itdaniher/auv-controller/board.png

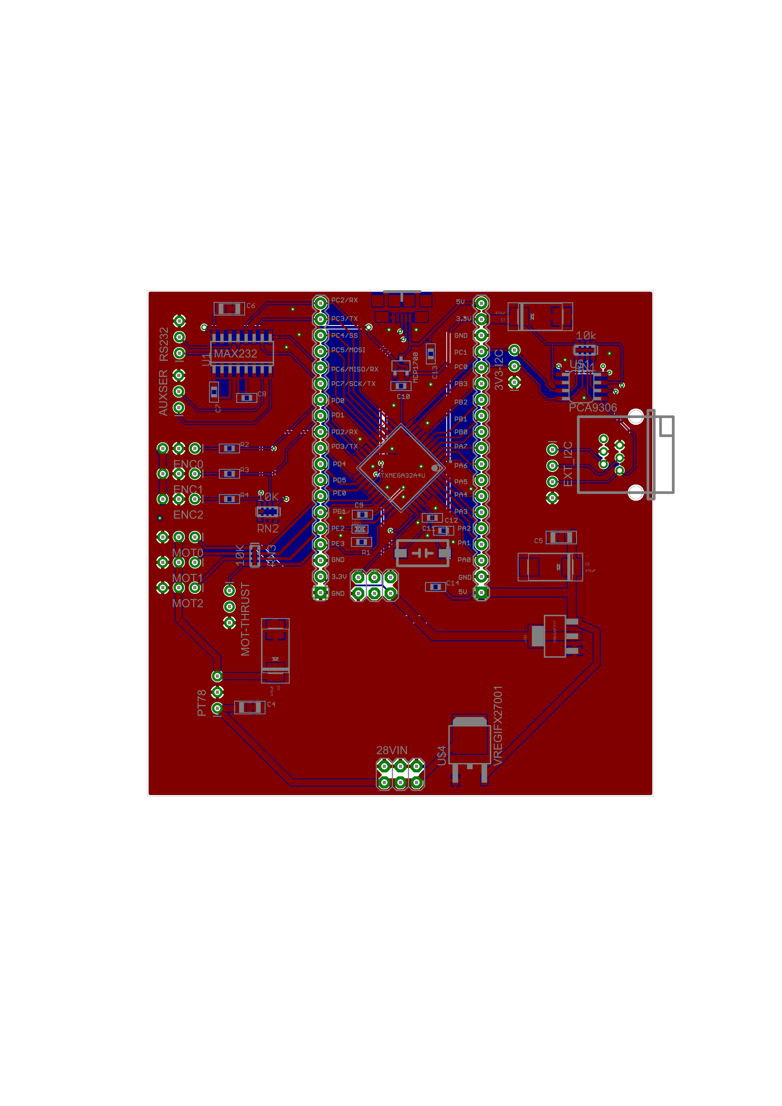
board.png
