itdaniher/auv-controller/schematic.png

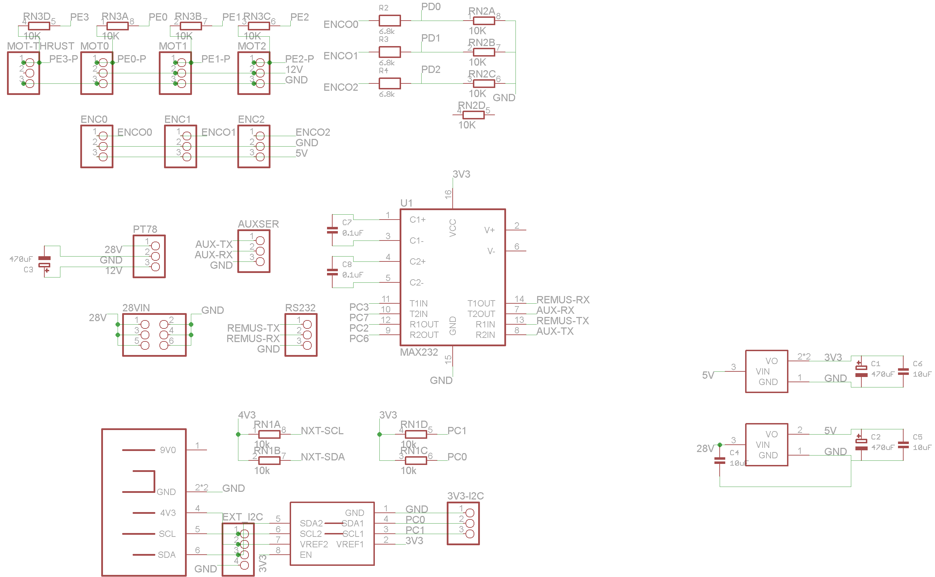
schematic.png
