itdaniher/auv-controller/mechanical/000_v3_REMUS_Tail_Assem.pdf

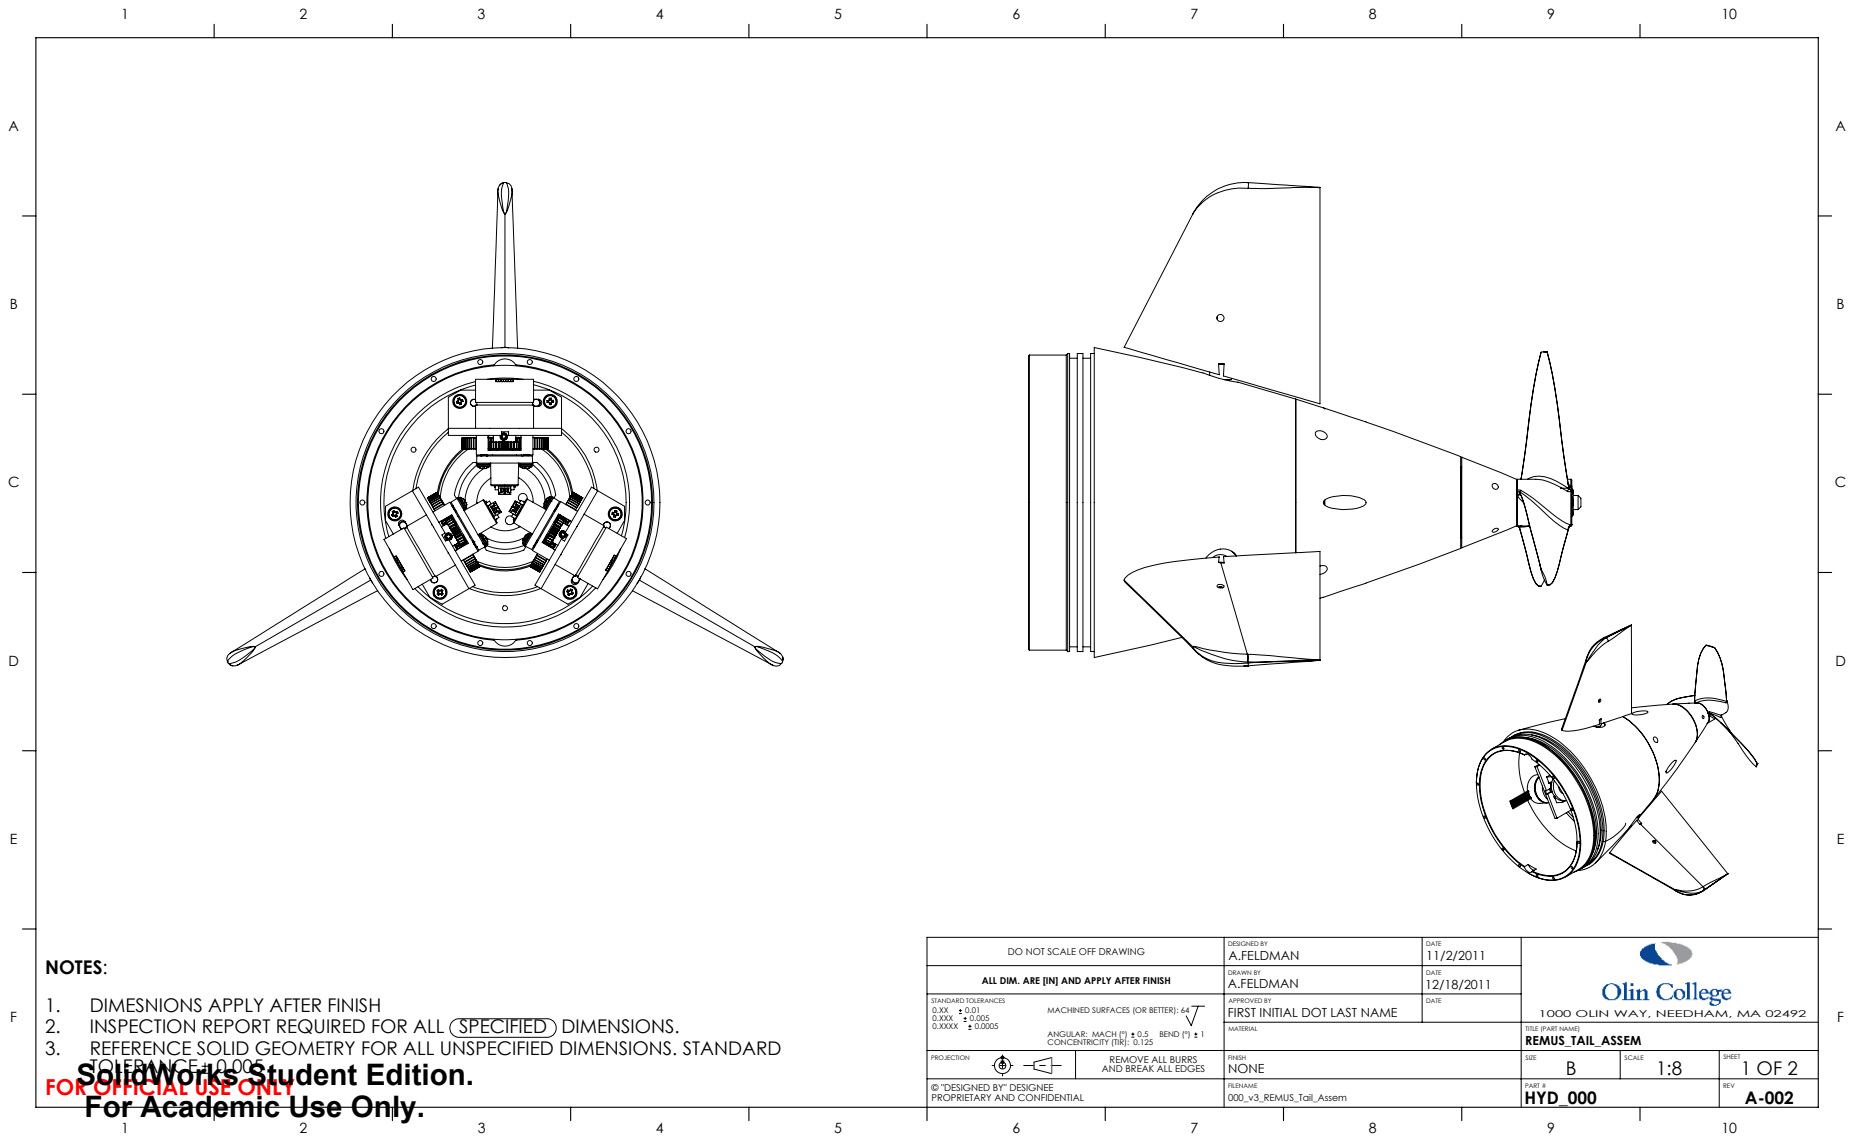
[picture p33: page 1]
2. INSPECTION REPORT REQUIRED FOR ALL; SPECIFIED; DIMENSIONS.; TOLERANCE; 0.005 SolidWorks Student Edition.

DO NOT SCALE OFF DRAWING | DESIGNED BY A.FELDMAN | DATE 11/2/2011 | 1000 OLIN WAY, NEEDHAM, MA 02492

NOTES:
1. DIMESNIONS APPLY AFTER FINISH
3. REFERENCE SOLID GEOMETRY FOR ALL UNSPECIFIED DIMENSIONS. STANDARD
HYD_000 FOR OFFICIAL USE ONLY
For Academic Use Only.

ALL DIM. ARE [IN] AND APPLY AFTER FINISH | DRAWN BY A.FELDMAN | DATE 12/18/2011

STANDARD TOLERANCES 0.XX 0.01 MACHINED SURFACES (OR BETTER): 64 0.XXX 0.005 0.XXXX 0.0005 ANGULAR: MACH (º) 0.5 BEND (º) 1 CONCENTRICITY (TIR): 0.125 | APPROVED BY FIRST INITIAL DOT LAST NAME | DATE

MATERIAL | | TITLE (PART NAME) REMUS_TAIL_ASSEM

PROJECTION | | | | REMOVE ALL BURRS AND BREAK ALL EDGES | FINISH NONE | SIZE B | SCALE 1:8 | SHEET 1 OF 2

© "DESIGNED BY" DESIGNEE PROPRIETARY AND CONFIDENTIAL | | | | | FILENAME 000_v3_REMUS_Tail_Assem | PART # | | REV A-002

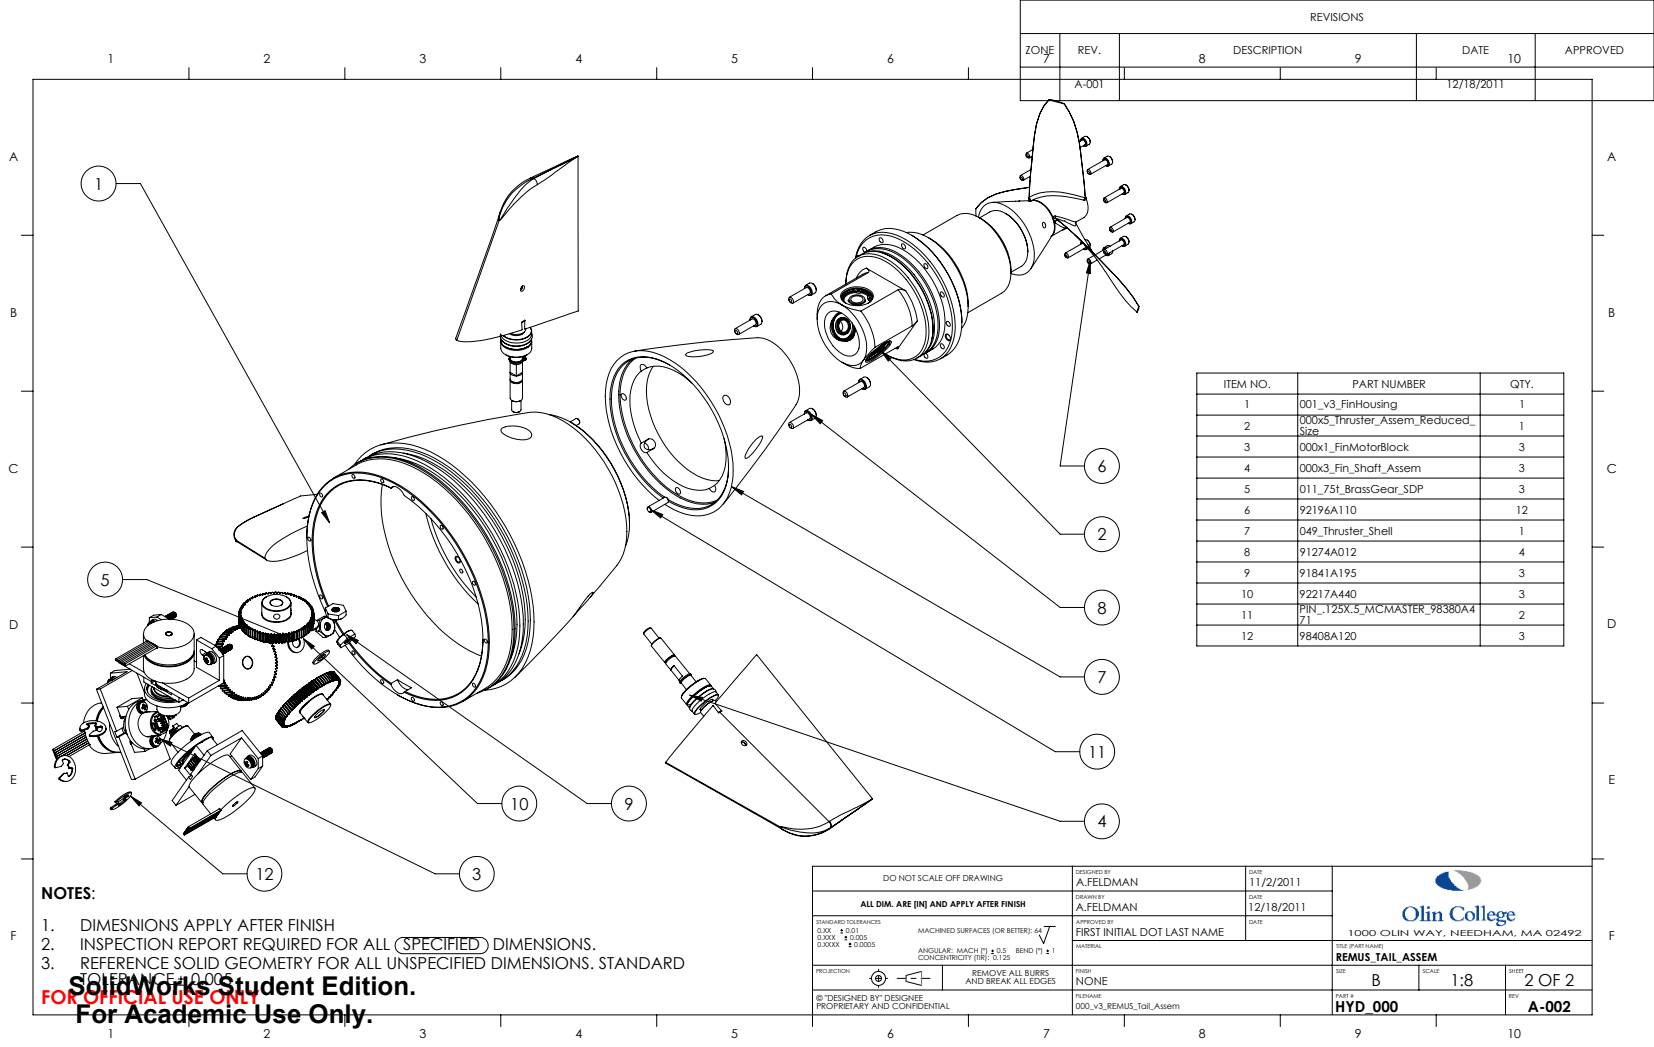
[picture p34: page 2]
2. INSPECTION REPORT REQUIRED FOR ALL; SPECIFIED; DIMENSIONS.; TOLERANCE; 0.005 SolidWorks Student Edition.

ITEM NO. | PART NUMBER | QTY.
1 | 001_v3_FinHousing | 1
2 | 000x5_Thruster_Assem_Reduced_ Size | 1
3 | 000x1_FinMotorBlock | 3
4 | 000x3_Fin_Shaft_Assem | 3
5 | 011_75t_BrassGear_SDP | 3
6 | 92196A110 | 12
7 | 049_Thruster_Shell | 1
8 | 91274A012 | 4
9 | 91841A195 | 3
10 | 92217A440 | 3
11 | PIN_.125X.5_MCMASTER_98380A4 71 | 2
12 | 98408A120 | 3

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

ALL DIM. ARE [IN] AND APPLY AFTER FINISH | DRAWN BY A.FELDMAN | DATE 12/18/2011

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

MATERIAL | | TITLE (PART NAME) REMUS_TAIL_ASSEM

PROJECTION | | | | REMOVE ALL BURRS AND BREAK ALL EDGES | FINISH NONE | SIZE B | SCALE 1:8 | SHEET 2 OF 2

© "DESIGNED BY" DESIGNEE PROPRIETARY AND CONFIDENTIAL | | | | | FILENAME 000_v3_REMUS_Tail_Assem | PART # | | REV A-002
