itdaniher/auv-controller/mechanical/000x1_FinMotorBlock.pdf

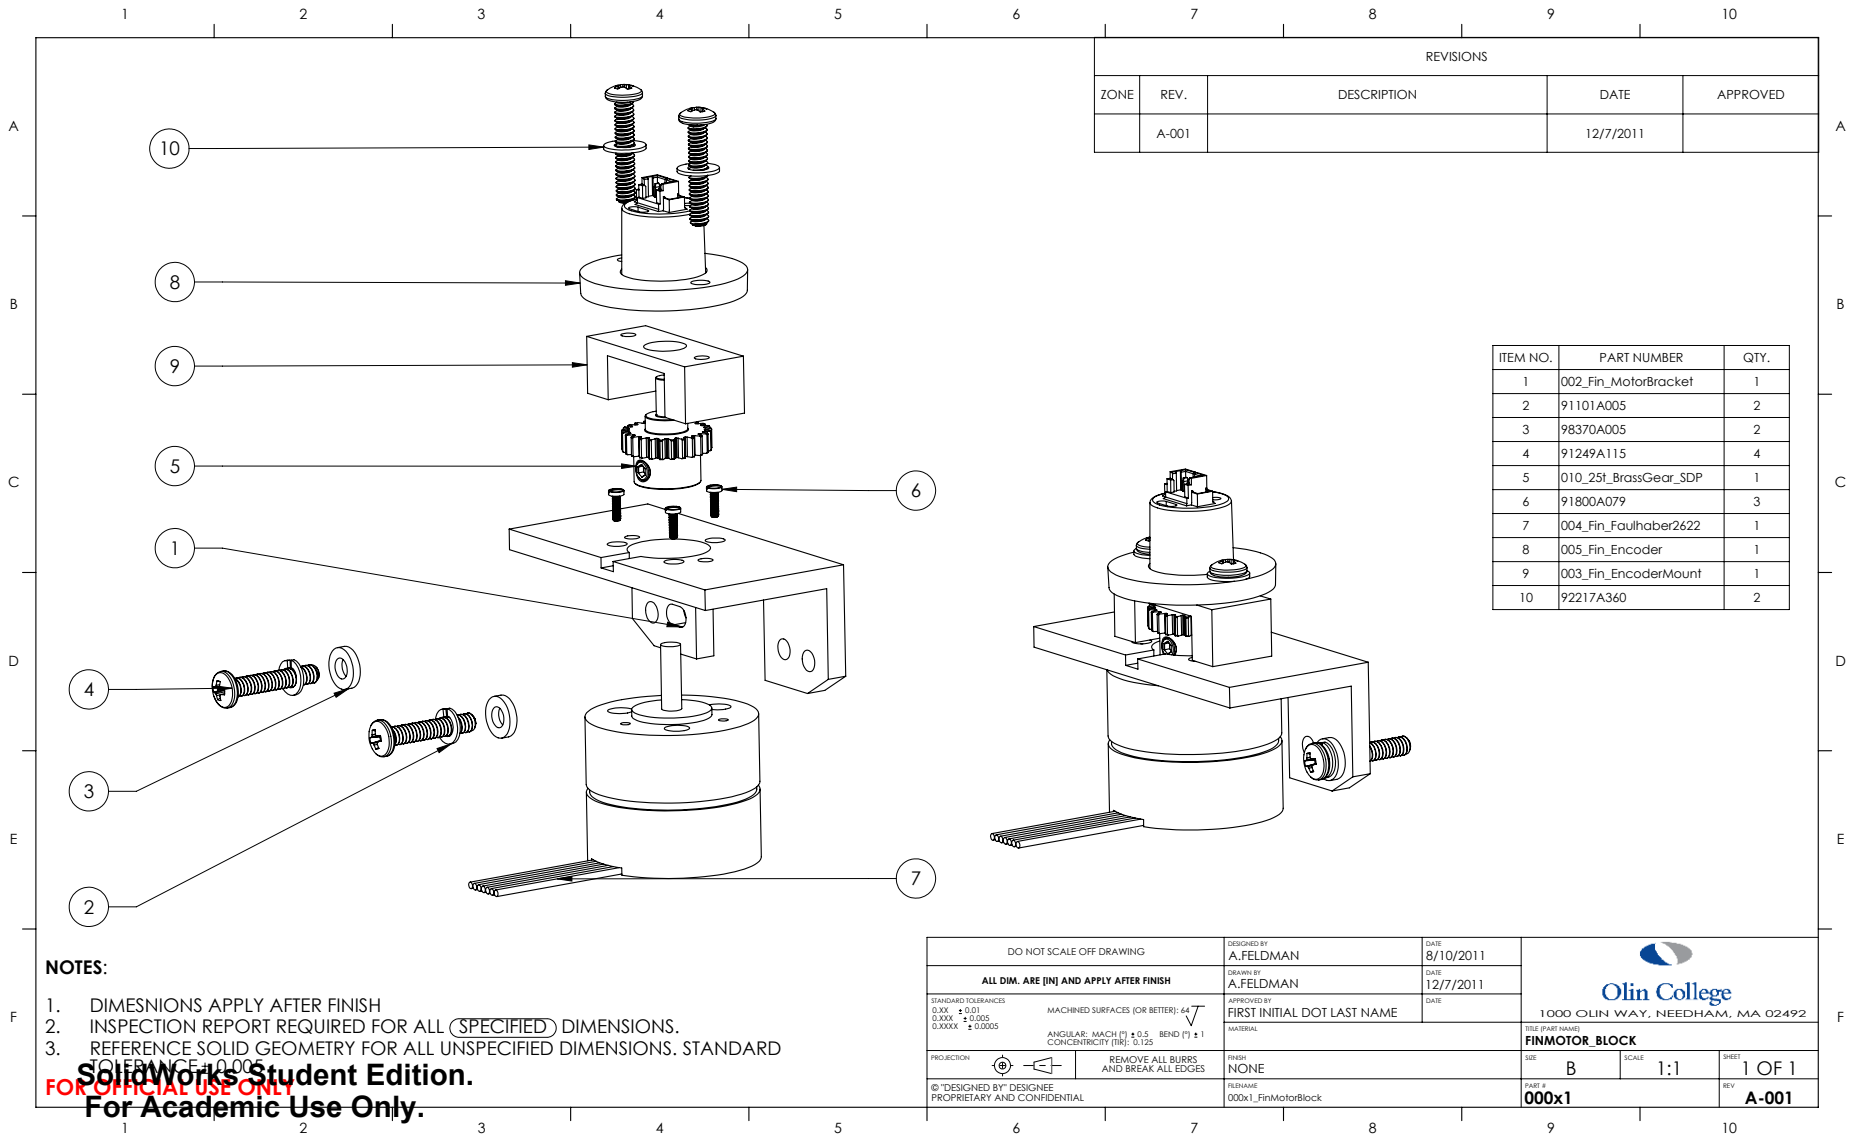
[picture p35: page 1]
2. INSPECTION REPORT REQUIRED FOR ALL; SPECIFIED; DIMENSIONS.; TOLERANCE; 0.005 SolidWorks Student Edition.

REVISIONS

ZONE | REV. | DESCRIPTION | DATE | APPROVED

ITEM NO. | PART NUMBER | QTY.
1 | 002_Fin_MotorBracket | 1
2 | 91101A005 | 2
3 | 98370A005 | 2
4 | 91249A115 | 4
5 | 010_25t_BrassGear_SDP | 1
6 | 91800A079 | 3
7 | 004_Fin_Faulhaber2622 | 1
8 | 005_Fin_Encoder | 1
9 | 003_Fin_EncoderMount | 1
10 | 92217A360 | 2

DO NOT SCALE OFF DRAWING | DESIGNED BY A.FELDMAN | DATE 8/10/2011 | 1000 OLIN WAY, NEEDHAM, MA 02492

NOTES:
1. DIMESNIONS APPLY AFTER FINISH
3. REFERENCE SOLID GEOMETRY FOR ALL UNSPECIFIED DIMENSIONS. STANDARD
000x1 FOR OFFICIAL USE ONLY
For Academic Use Only.

ALL DIM. ARE [IN] AND APPLY AFTER FINISH | DRAWN BY A.FELDMAN | DATE 12/7/2011

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

MATERIAL | | TITLE (PART NAME) FINMOTOR_BLOCK

PROJECTION | | | | REMOVE ALL BURRS AND BREAK ALL EDGES | FINISH NONE | SIZE B | SCALE 1:1 | SHEET 1 OF 1

© "DESIGNED BY" DESIGNEE PROPRIETARY AND CONFIDENTIAL | | | | | FILENAME 000x1_FinMotorBlock | PART # | | REV A-001
