itdaniher/auv-controller/mechanical/000x6_Thruster_Assem_Stator.pdf

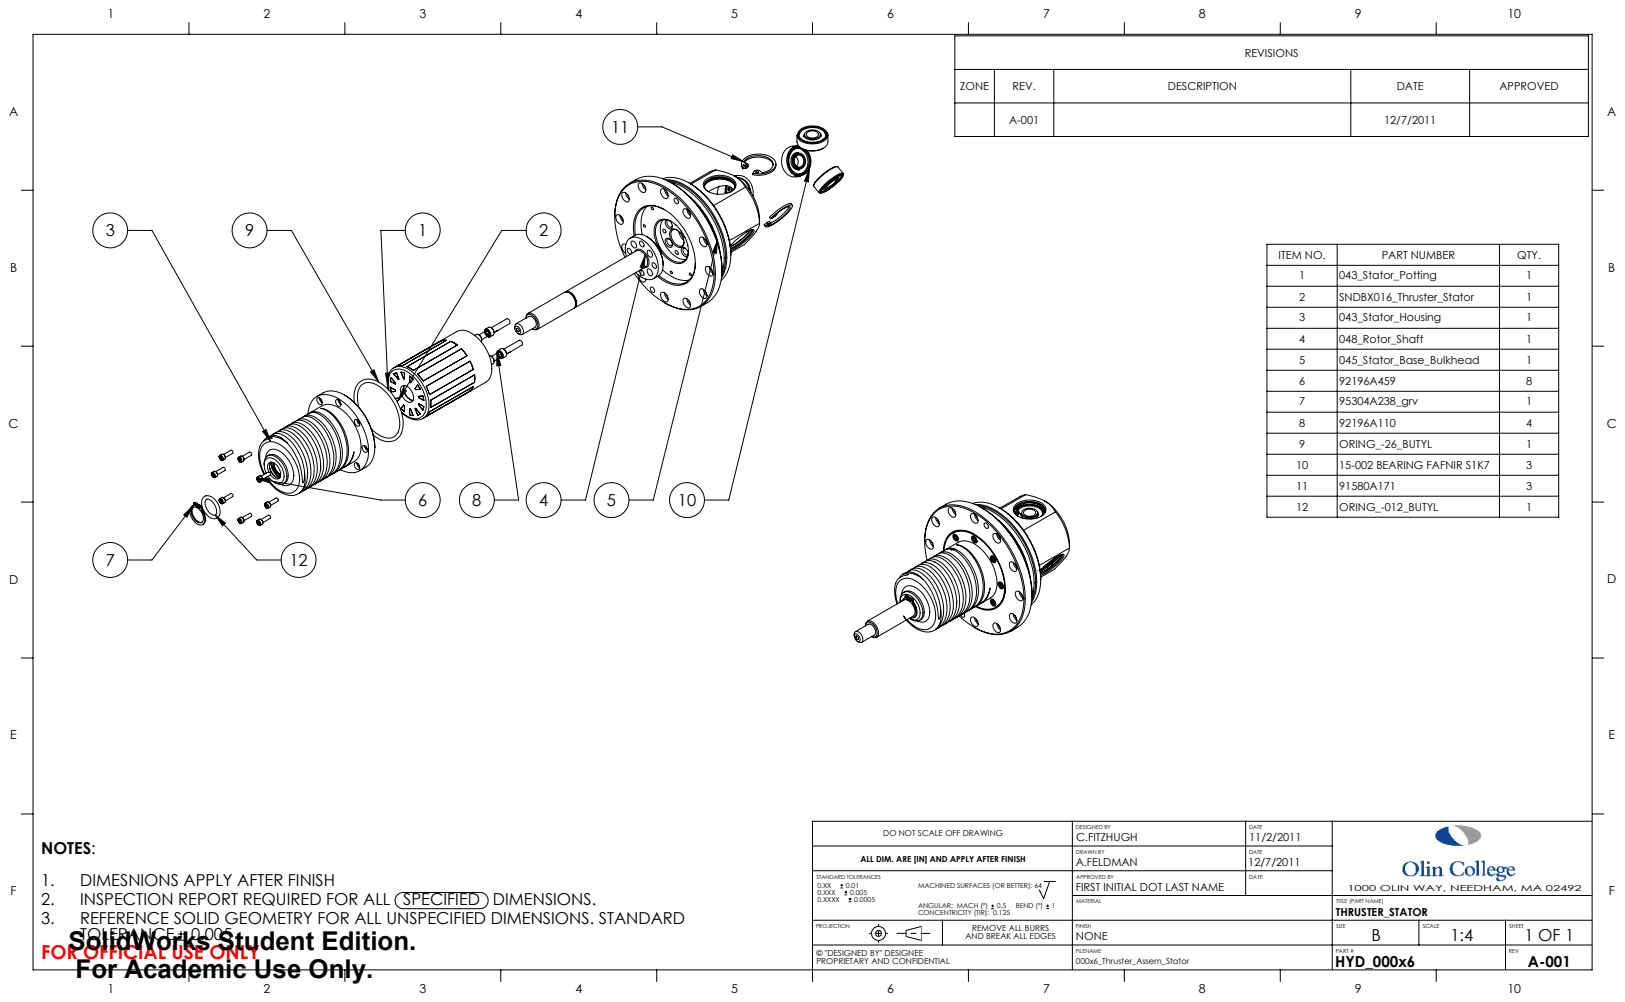
[picture p36: page 1]
2. INSPECTION REPORT REQUIRED FOR ALL; SPECIFIED; DIMENSIONS.; TOLERANCE; 0.005 SolidWorks Student Edition.

ZONE | REV. | DESCRIPTION | DATE | APPROVED

ITEM NO. | PART NUMBER | QTY.
1 | 043_Stator_Potting | 1
2 | SNDBX016_Thruster_Stator | 1
3 | 043_Stator_Housing | 1
4 | 048_Rotor_Shaft | 1
5 | 045_Stator_Base_Bulkhead | 1
6 | 92196A459 | 8
7 | 95304A238_grv | 1
8 | 92196A110 | 4
9 | ORING_-26_BUTYL | 1
10 | 15-002 BEARING FAFNIR S1K7 | 3
11 | 91580A171 | 3
12 | ORING_-012_BUTYL | 1

DO NOT SCALE OFF DRAWING | DESIGNED BY C.FITZHUGH | DATE 11/2/2011 | 1000 OLIN WAY, NEEDHAM, MA 02492

NOTES:
1. DIMESNIONS APPLY AFTER FINISH
3. REFERENCE SOLID GEOMETRY FOR ALL UNSPECIFIED DIMENSIONS. STANDARD
HYD_000x6 FOR OFFICIAL USE ONLY
For Academic Use Only.

ALL DIM. ARE [IN] AND APPLY AFTER FINISH | DRAWN BY A.FELDMAN | DATE 12/7/2011

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

MATERIAL | | TITLE (PART NAME) THRUSTER_STATOR

PROJECTION | | | | REMOVE ALL BURRS AND BREAK ALL EDGES | FINISH NONE | SIZE B | SCALE 1:4 | SHEET 1 OF 1

© "DESIGNED BY" DESIGNEE PROPRIETARY AND CONFIDENTIAL | | | | | FILENAME 000x6_Thruster_Assem_Stator | PART # | | REV A-001
