itdaniher/auv-controller/mechanical/001_v3_FinHousing.pdf

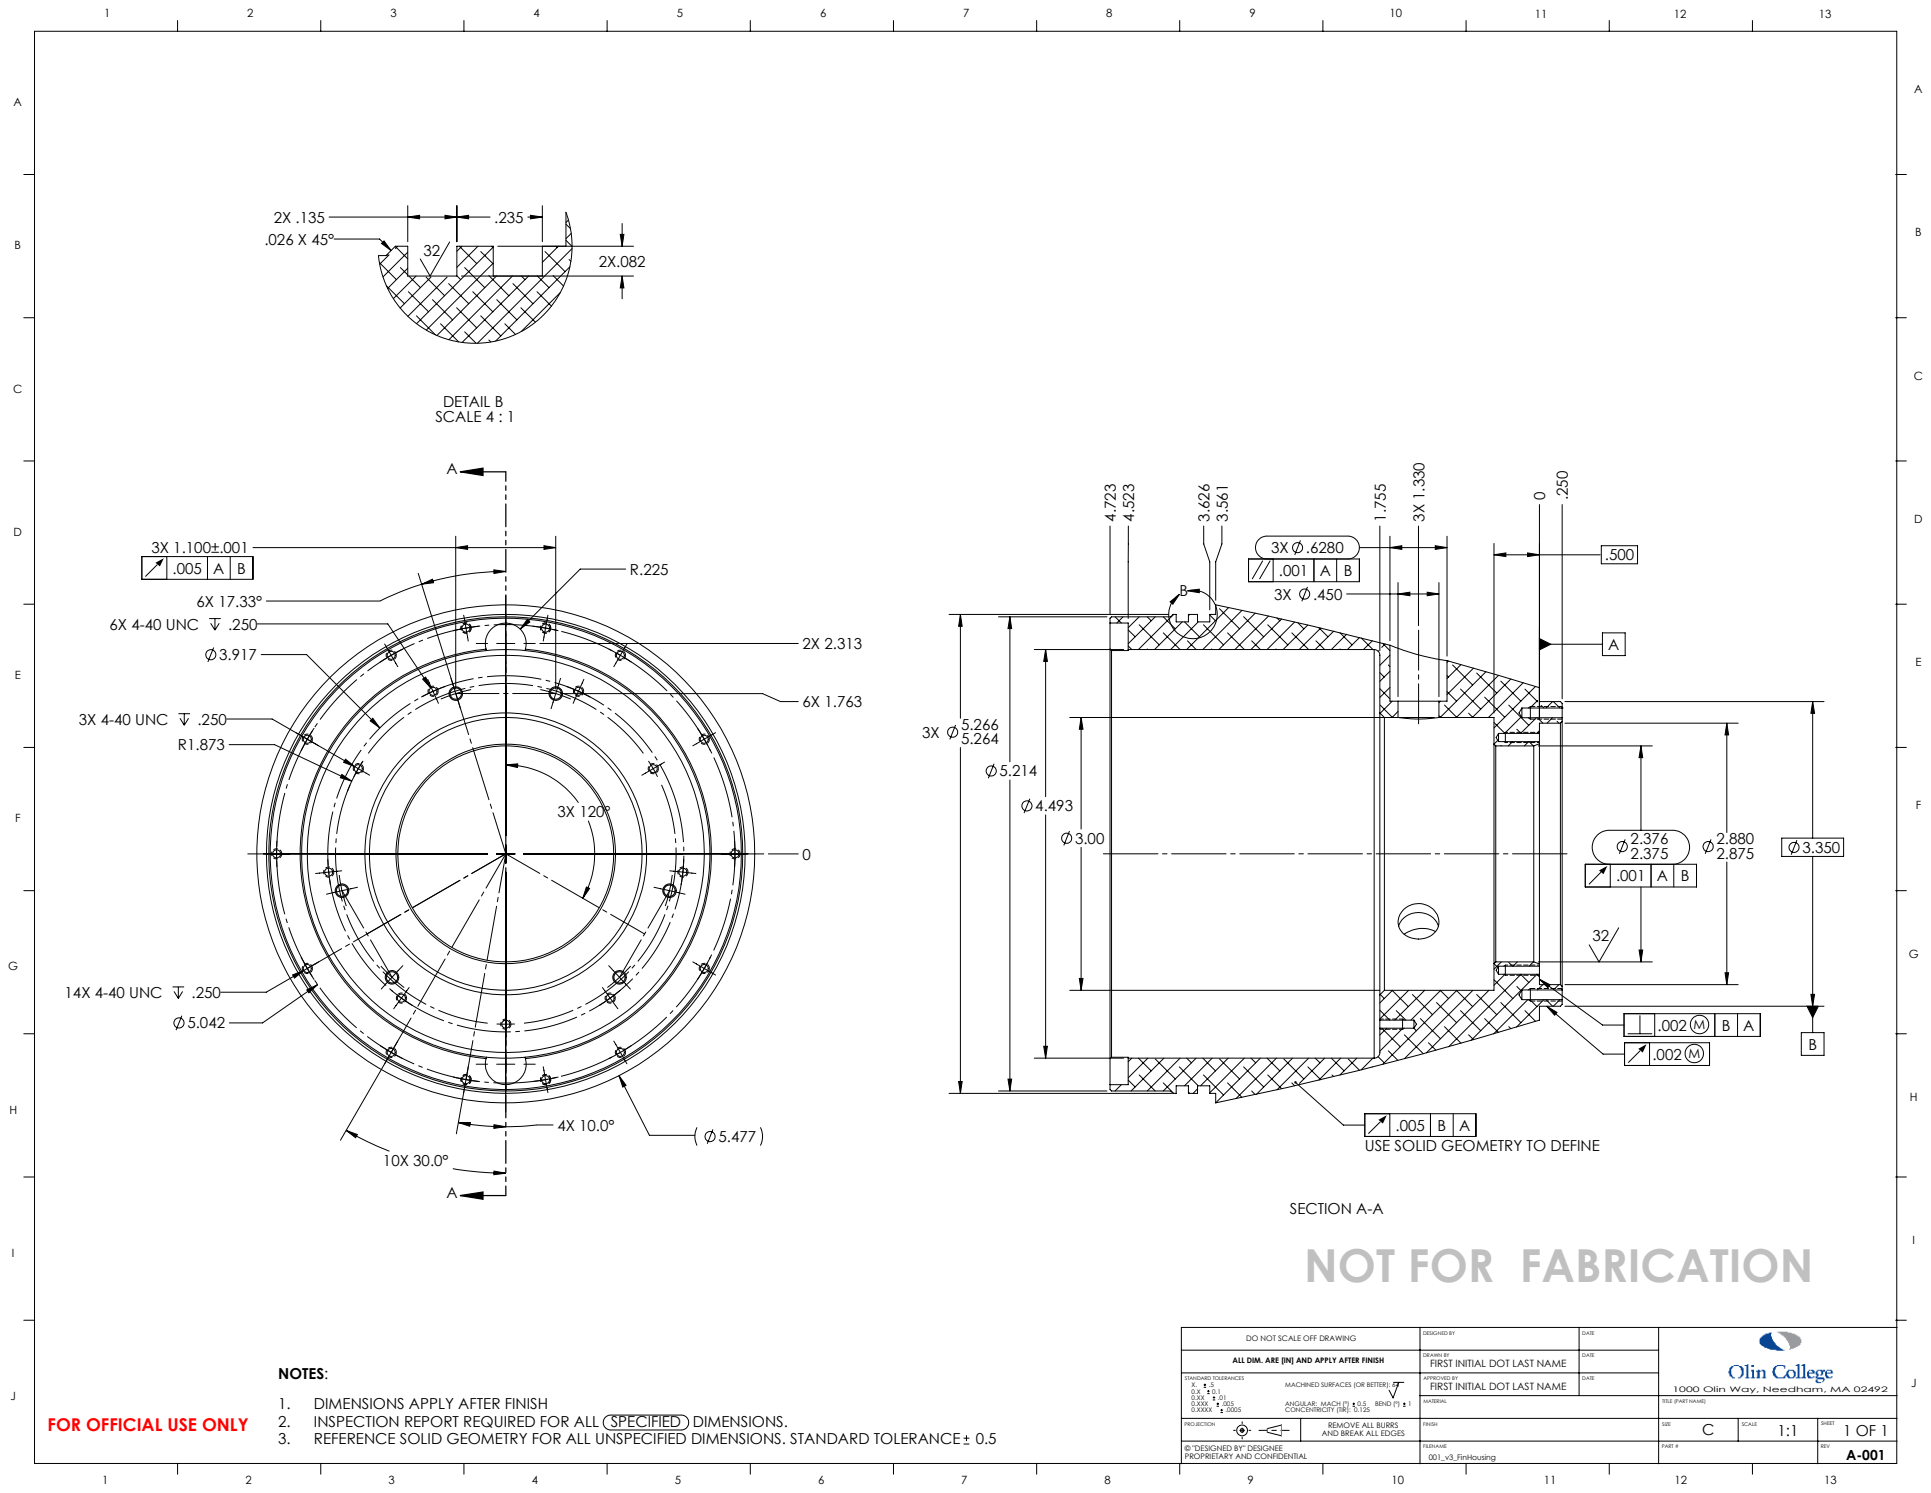
[picture p37: page 1]
3X 4-40 UNC; 6X 4-40 UNC; 14X 4-40 UNC; SECTION A-A; DETAIL B SCALE 4 : 1; 3. REFERENCE SOLID GEOMETRY FOR ALL UNSPECIFIED DIMENSIONS. STANDARD TOLERANCE; 1:1 FOR OFFICIAL USE ONLY

USE SOLID GEOMETRY TO DEFINE
NOT FOR FABRICATION

DO NOT SCALE OFF DRAWING | DESIGNED BY | DATE | 1000 Olin Way, Needham, MA 02492

ALL DIM. ARE [IN] AND APPLY AFTER FINISH | DRAWN BY FIRST INITIAL DOT LAST NAME | DATE

NOTES:
1. DIMENSIONS APPLY AFTER FINISH
2. INSPECTION REPORT REQUIRED FOR ALL SPECIFIED DIMENSIONS.

STANDARD TOLERANCES X. .5 0.X 0.1 MACHINED SURFACES (OR BETTER): 64 0.XX .01 0.XXX .005 ANGULAR: MACH (º) 0.5 BEND (º) 1 0.XXXX .0005 CONCENTRICITY (TIR): 0.125 | APPROVED BY FIRST INITIAL DOT LAST NAME | DATE

MATERIAL | | TITLE (PART NAME)

PROJECTION | | | | REMOVE ALL BURRS AND BREAK ALL EDGES | FINISH | SIZE | SCALE | SHEET

© "DESIGNED BY" DESIGNEE PROPRIETARY AND CONFIDENTIAL | | | | | FILENAME 001_v3_FinHousing | PART # | | REV A-001
