itdaniher/auv-controller/board.brd

## EAGLE design board.brd (2012-12-20)

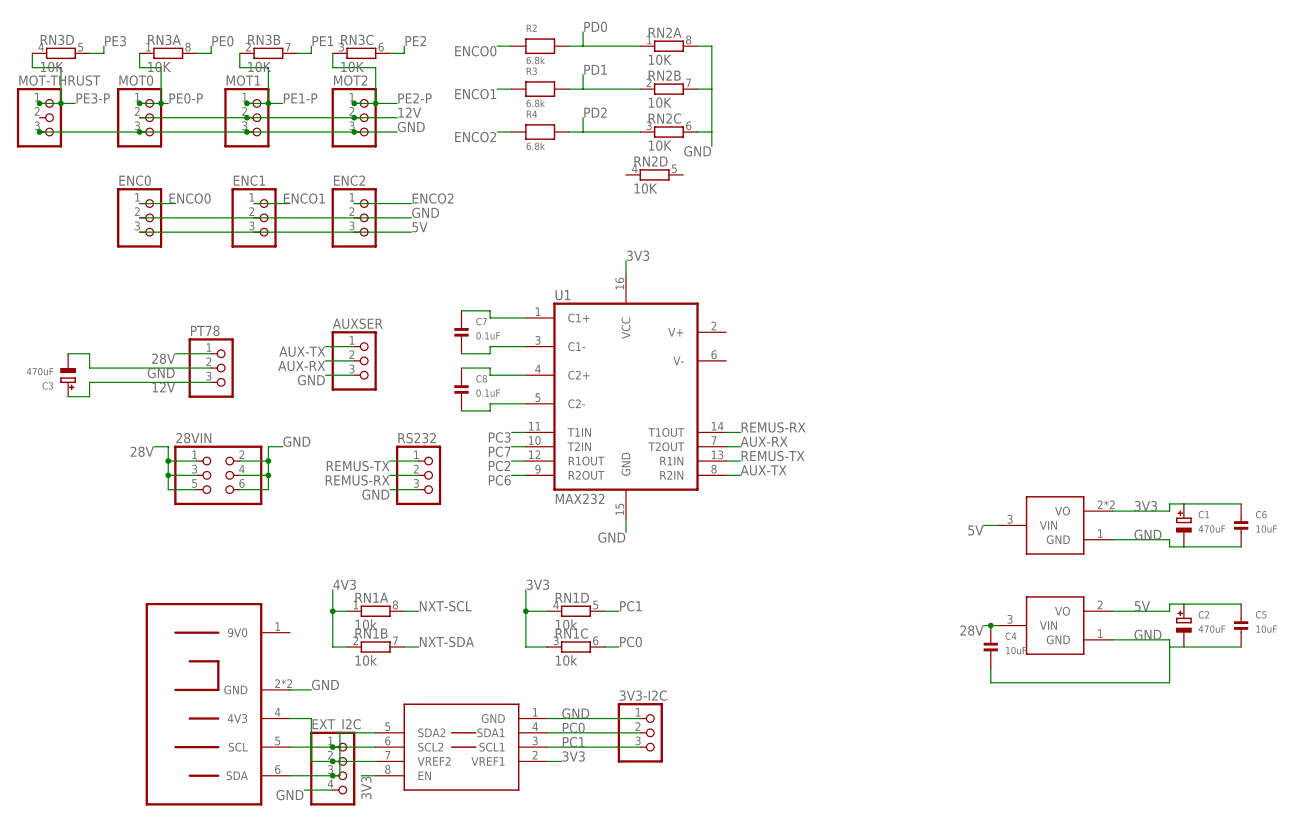
[picture p38: schematic board.sch, sheet 1]

Parts:
3V3-I2C: HEADER-1X3ROUND; 1X03_ROUND
28VIN: HEADER-2X3; 2X03
AUXSER: HEADER-1X3ROUND; 1X03_ROUND
C1, C2, C3: 470uF; EIA7343-31/D-W
C4, C5, C6: 10uF; 1206
C7, C8: 0.1uF; 0603
ENC0, ENC1, ENC2: HEADER-1X3ROUND; 1X03_ROUND
EXT_I2C: HEADER-1X4ROUND; 1X04_ROUND
MOT0, MOT1, MOT2: HEADER-1X3ROUND; 1X03_ROUND
MOT-THRUST: HEADER-1X3ROUND; 1X03_ROUND
PT78: HEADER-1X3ROUND; 1X03_ROUND
R2, R3, R4: 6.8k; 0603
RN1: 10k; RN8P-4R-CRA06S
RN2, RN3: 10K; RN8P-4R-CRA06S
RS232: HEADER-1X3ROUND; 1X03_ROUND
U1: MAX232; SO-16
U$1: PCA9306; SO-08
U$2: NXT-CONNECTOR; NXT-FOOTPRINT
U$3: VREGAP1117; SOT223
U$4: VREGIFX27001; TO252

Connections:
3V3: C1.+, C6.1, RN1.3 (1), RN1.4 (1), U1.16 (VCC), U$1.2 (VREF1), U$1.8 (EN), U$3.2 (VO), U$3.4 (VO); also elsewhere on the board
4V3: EXT_I2C.2, RN1.1, RN1.2 (1), U$1.7 (VREF2), U$2.4 (4V3)
5V: C2.+, C5.1, ENC0.3, ENC1.3, ENC2.3, U$3.3 (VIN), U$4.2 (VO); also elsewhere on the board
12V: C3.+, MOT0.2, MOT1.2, MOT2.2, PT78.3
28V: 28VIN.1, 28VIN.3, 28VIN.5, C4.1, PT78.1, U$4.3 (VIN)
AUX-RX: AUXSER.2, U1.7 (T2OUT)
AUX-TX: AUXSER.1, U1.8 (R2IN)
C1+: C7.1, U1.1 (C1+)
C1-: C7.2, U1.3 (C1-)
C2+: C8.1, U1.4 (C2+)
C2-: C8.2, U1.5 (C2-)
ENCO0: ENC0.1, R2.1
ENCO1: ENC1.1, R3.1
ENCO2: ENC2.1, R4.1
GND: 3V3-I2C.1, 28VIN.2, 28VIN.4, 28VIN.6, AUXSER.3, C1.-, C3.-, C4.2, C5.2, C6.2, ENC0.2, ENC1.2, ENC2.2, EXT_I2C.4, MOT0.3, MOT1.3, MOT2.3, MOT-THRUST.3, PT78.2, RN2.6 (2), RN2.7 (2), RN2.8 (2), RS232.3, U1.15 (GND), U$1.1 (GND), U$2.2 (GND), U$2.3 (GND), U$3.1 (GND), U$4.1 (GND); also elsewhere on the board
NXT-SCL: EXT_I2C.1, RN1.8 (2), U$1.6 (SCL2), U$2.5 (SCL)
NXT-SDA: EXT_I2C.3, RN1.7 (2), U$1.5 (SDA2), U$2.6 (SDA)
PC0: 3V3-I2C.2, RN1.6 (2), U$1.4 (SDA1); also elsewhere on the board
PC1: 3V3-I2C.3, RN1.5 (2), U$1.3 (SCL1); also elsewhere on the board
PC2: U1.12 (R1OUT); also elsewhere on the board
PC3: U1.11 (T1IN); also elsewhere on the board
PC6: U1.9 (R2OUT); also elsewhere on the board
PC7: U1.10 (T2IN); also elsewhere on the board
PD0: R2.2, RN2.1; also elsewhere on the board
PD1: R3.2, RN2.2 (1); also elsewhere on the board
PD2: R4.2, RN2.3 (1); also elsewhere on the board
PE0: RN3.8 (2); also elsewhere on the board
PE0-P: MOT0.1, RN3.1
PE1: RN3.7 (2); also elsewhere on the board
PE1-P: MOT1.1, RN3.2 (1)
PE2: RN3.6 (2); also elsewhere on the board
PE2-P: MOT2.1, RN3.3 (1)
PE3: RN3.5 (2); also elsewhere on the board
PE3-P: MOT-THRUST.1, RN3.4 (1)
REMUS-RX: RS232.2, U1.14 (T1OUT)
REMUS-TX: RS232.1, U1.13 (R1IN)

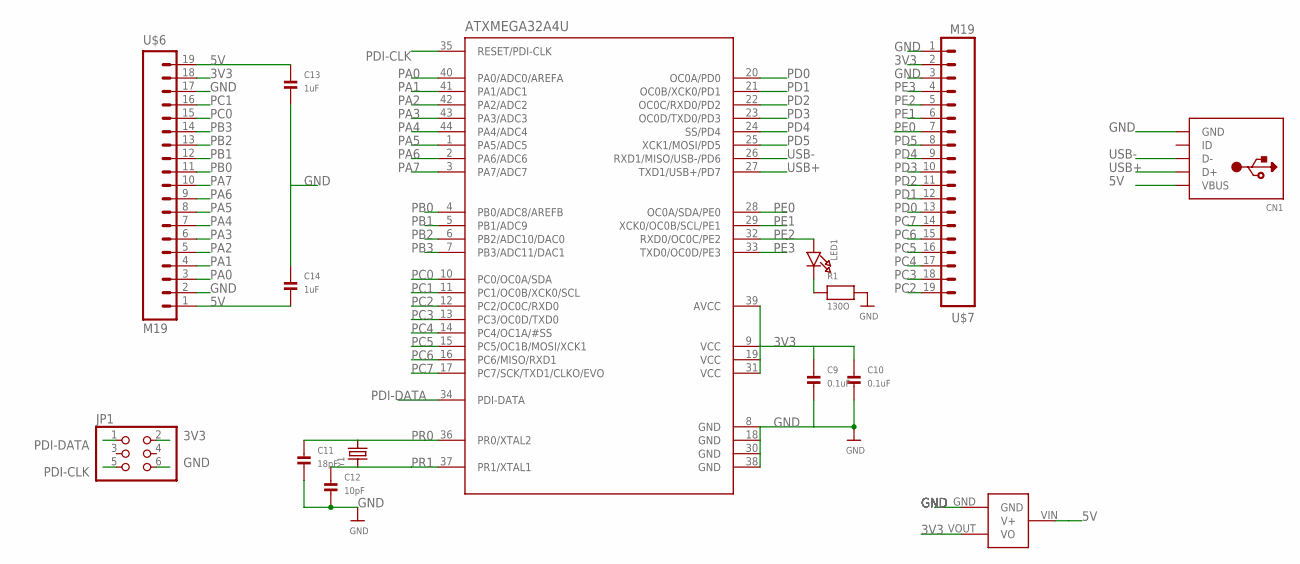
[picture p39: schematic board.sch, sheet 2]

Parts:
ATXMEGA32A4U: ATXMEGAXXA4U-AU; TQFP-44
C9, C10: 0.1uF; 0603
C11: 18pF; 0603
C12: 10pF; 0603
C13, C14: 1uF; 0603
CN1: USBMICROB; USB-MICROB
JP1: HEADER-2X3; 2X03
LED1: LED0603; CHIPLED_0603
R1: 130O; 0603
U$5: MCP1700; SOT23-3
U$6, U$7: M19; 1X19
Y1: CRYSTAL; NX8045GB

Connections:
3V3: ATXMEGA32A4U.9 (VCC), ATXMEGA32A4U.19 (VCC), ATXMEGA32A4U.31 (VCC), ATXMEGA32A4U.39 (AVCC), C9.1, C10.1, JP1.2, U$5.VOUT (VO), U$6.18, U$7.2; also elsewhere on the board
5V: C13.1, C14.2, CN1.P1 (VBUS), U$5.VIN (V+), U$6.1, U$6.19; also elsewhere on the board
GND: ATXMEGA32A4U.8 (GND), ATXMEGA32A4U.18 (GND), ATXMEGA32A4U.30 (GND), ATXMEGA32A4U.38 (GND), C9.2, C10.2, C11.2, C12.2, C13.2, C14.1, CN1.P5 (GND), JP1.6, R1.2, U$5.GND, U$6.2, U$6.17, U$7.1, U$7.3; also elsewhere on the board
unnamed: LED1.C, R1.1
PA0: ATXMEGA32A4U.40 (PA0/ADC0/AREFA), U$6.3
PA1: ATXMEGA32A4U.41 (PA1/ADC1), U$6.4
PA2: ATXMEGA32A4U.42 (PA2/ADC2), U$6.5
PA3: ATXMEGA32A4U.43 (PA3/ADC3), U$6.6
PA4: ATXMEGA32A4U.44 (PA4/ADC4), U$6.7
PA5: ATXMEGA32A4U.1 (PA5/ADC5), U$6.8
PA6: ATXMEGA32A4U.2 (PA6/ADC6), U$6.9
PA7: ATXMEGA32A4U.3 (PA7/ADC7), U$6.10
PB0: ATXMEGA32A4U.4 (PB0/ADC8/AREFB), U$6.11
PB1: ATXMEGA32A4U.5 (PB1/ADC9), U$6.12
PB2: ATXMEGA32A4U.6 (PB2/ADC10/DAC0), U$6.13
PB3: ATXMEGA32A4U.7 (PB3/ADC11/DAC1), U$6.14
PC0: ATXMEGA32A4U.10 (PC0/OC0A/SDA), U$6.15; also elsewhere on the board
PC1: ATXMEGA32A4U.11 (PC1/OC0B/XCK0/SCL), U$6.16; also elsewhere on the board
PC2: ATXMEGA32A4U.12 (PC2/OC0C/RXD0), U$7.19; also elsewhere on the board
PC3: ATXMEGA32A4U.13 (PC3/OC0D/TXD0), U$7.18; also elsewhere on the board
PC4: ATXMEGA32A4U.14 (PC4/OC1A/#SS), U$7.17
PC5: ATXMEGA32A4U.15 (PC5/OC1B/MOSI/XCK1), U$7.16
PC6: ATXMEGA32A4U.16 (PC6/MISO/RXD1), U$7.15; also elsewhere on the board
PC7: ATXMEGA32A4U.17 (PC7/SCK/TXD1/CLKO/EVO), U$7.14; also elsewhere on the board
PD0: ATXMEGA32A4U.20 (OC0A/PD0), U$7.13; also elsewhere on the board
PD1: ATXMEGA32A4U.21 (OC0B/XCK0/PD1), U$7.12; also elsewhere on the board
PD2: ATXMEGA32A4U.22 (OC0C/RXD0/PD2), U$7.11; also elsewhere on the board
PD3: ATXMEGA32A4U.23 (OC0D/TXD0/PD3), U$7.10
PD4: ATXMEGA32A4U.24 (SS/PD4), U$7.9
PD5: ATXMEGA32A4U.25 (XCK1/MOSI/PD5), U$7.8
PDI-CLK: ATXMEGA32A4U.35 (RESET/PDI-CLK), JP1.5
PDI-DATA: ATXMEGA32A4U.34 (PDI-DATA), JP1.1
PE0: ATXMEGA32A4U.28 (OC0A/SDA/PE0), U$7.7; also elsewhere on the board
PE1: ATXMEGA32A4U.29 (XCK0/OC0B/SCL/PE1), U$7.6; also elsewhere on the board
PE2: ATXMEGA32A4U.32 (RXD0/OC0C/PE2), LED1.A, U$7.5; also elsewhere on the board
PE3: ATXMEGA32A4U.33 (TXD0/OC0D/PE3), U$7.4; also elsewhere on the board
PR0: ATXMEGA32A4U.36 (PR0/XTAL2), C11.1, Y1.P$2 (2)
PR1: ATXMEGA32A4U.37 (PR1/XTAL1), C12.1, Y1.P$1 (1)
USB+: ATXMEGA32A4U.27 (TXD1/USB+/PD7), CN1.P3 (D+)
USB-: ATXMEGA32A4U.26 (RXD1/MISO/USB-/PD6), CN1.P2 (D-)

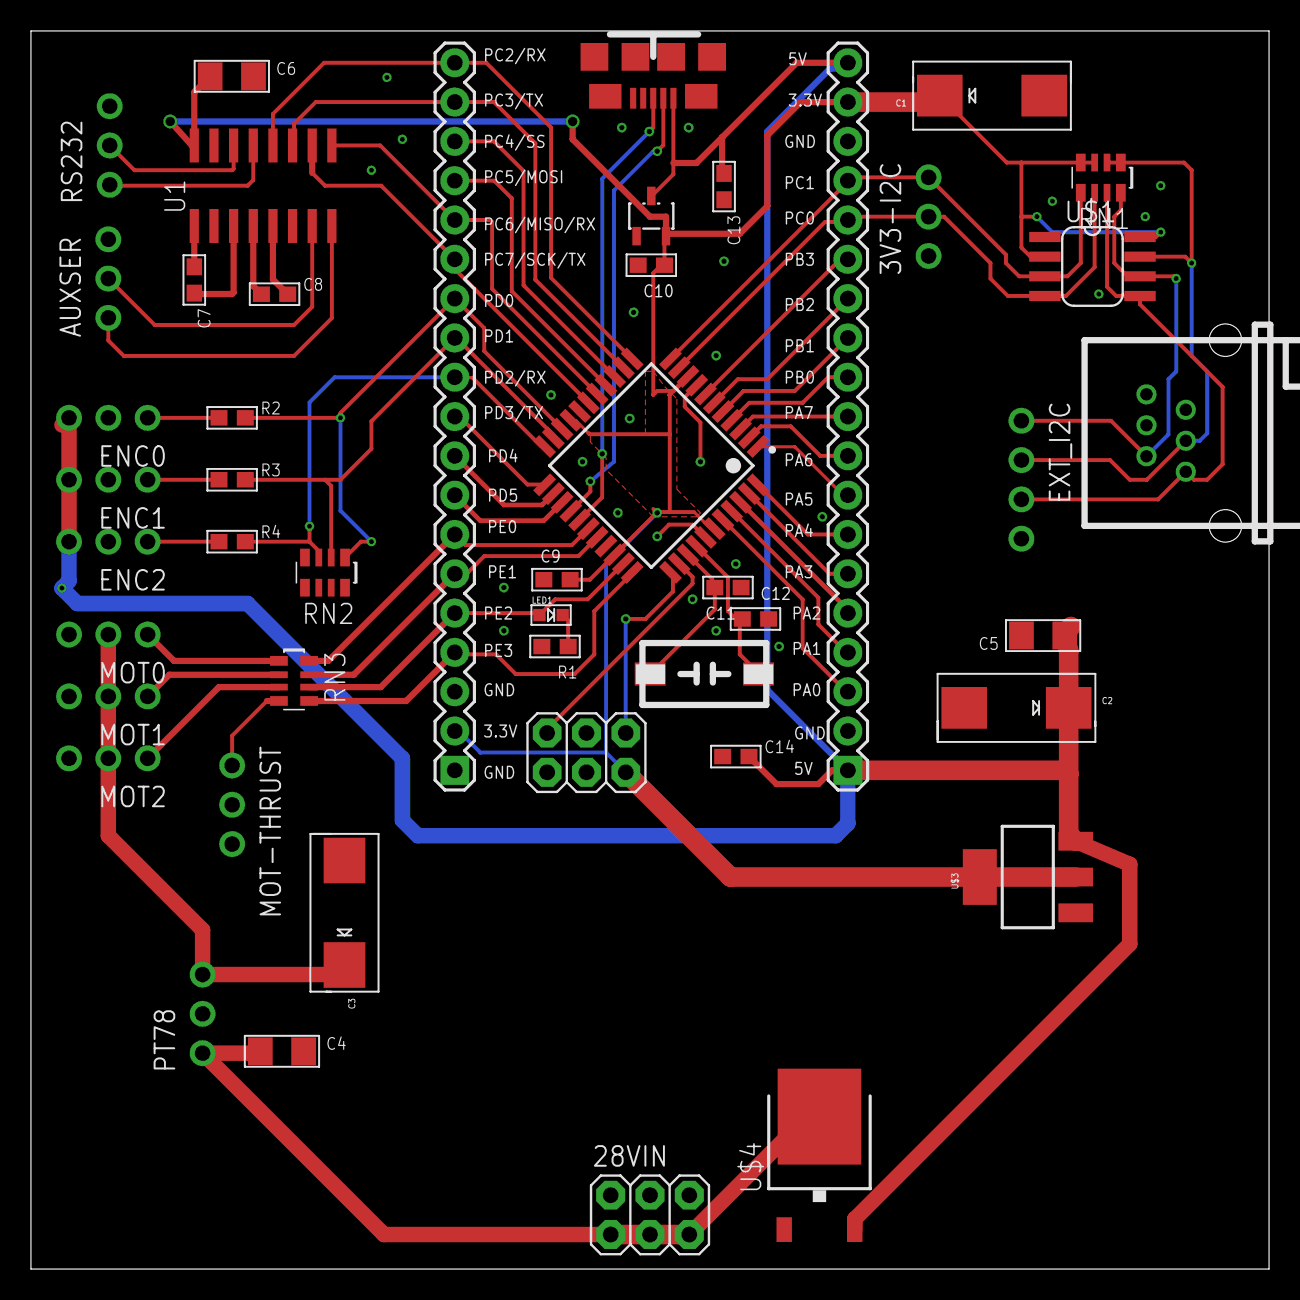
[picture p40: board board.brd from above]

Board: 2 copper layers, 80.0 x 80.0 mm, 47 parts (0 on the bottom side), 60 nets.
