itdaniher/auv-controller/(commit log)

2012-11-26 added links to interface circuitry
2012-11-26 added base board as a git submodule
2012-11-26 added link to purchased NXT interface connectors
2012-11-26 added link to PCA9306, sucklesser I2C level shifter
2012-11-26 added bits of BOM
2012-11-28 few thoughts on powering etc
2012-11-28 add P/N for power wing
2012-11-29 notes on motor psu solutions
2012-11-29 link to boost regulator datasheet
2012-12-01 added NXT connector from Silas. A++
2012-12-01 updated 12v/3v3 interface chip selection
2012-12-02 added prelim schem
    [smash.sch]
2012-12-20 added board files
    [smash.brd, smash.sch]
2012-12-20 rename board files to be sane
    [board.brd, board.sch]
2012-12-20 added gitignore, tweaked board
    [board.brd, board.sch]
2012-12-20 add some part values, nudge some traces
    [board.brd, board.sch]
2012-12-27 added BOM info
