itdaniher/auv-controller/(notices)

Notices in the files:
board.brd:
CC-By-SA
